Jaycar-Electronics/WiFi-Rover/docs/images/battery.png

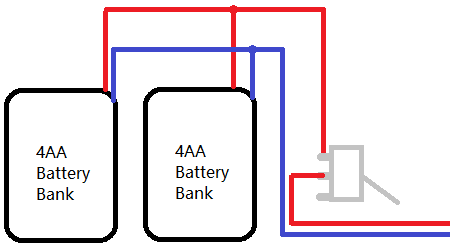
docs/images/battery.png
