Jaycar-Electronics/WiFi-Rover/docs/images/IMAG1243.jpg

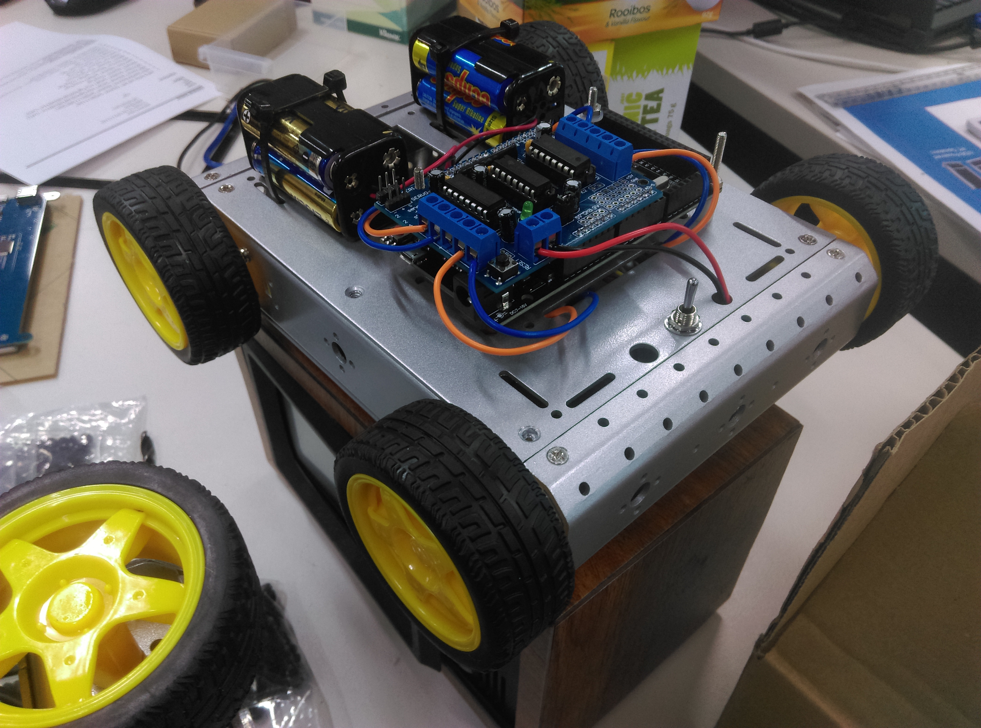
docs/images/IMAG1243.jpg
