Jaycar-Electronics/WiFi-Rover/docs/images/motor.png

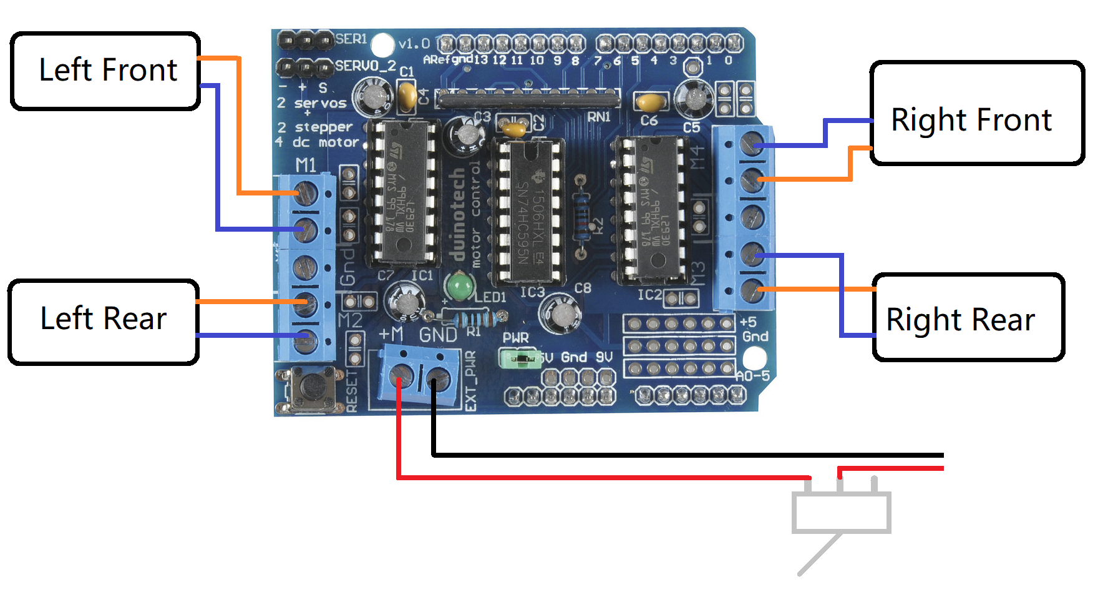
docs/images/motor.png
