Jaycar-Electronics/WiFi-Rover/docs/images/overview2.jpg

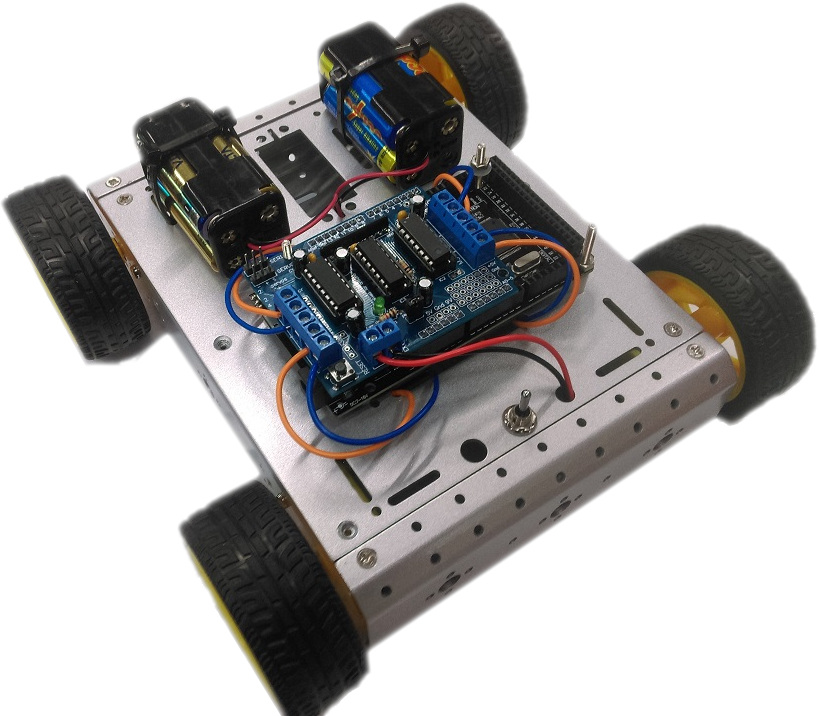
docs/images/overview2.jpg
