Jaycar-Electronics/WiFi-Rover/docs/images/overview.jpg

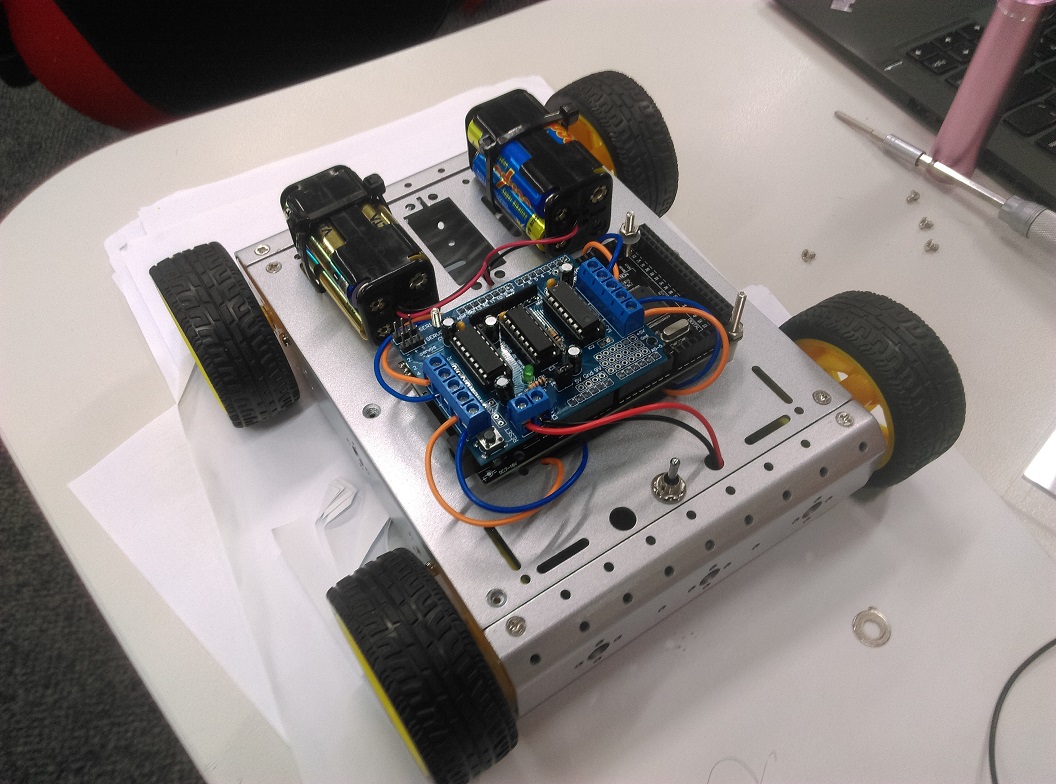
docs/images/overview.jpg
