Jaycar-Electronics/WiFi-Rover/docs/images/roverdata.png

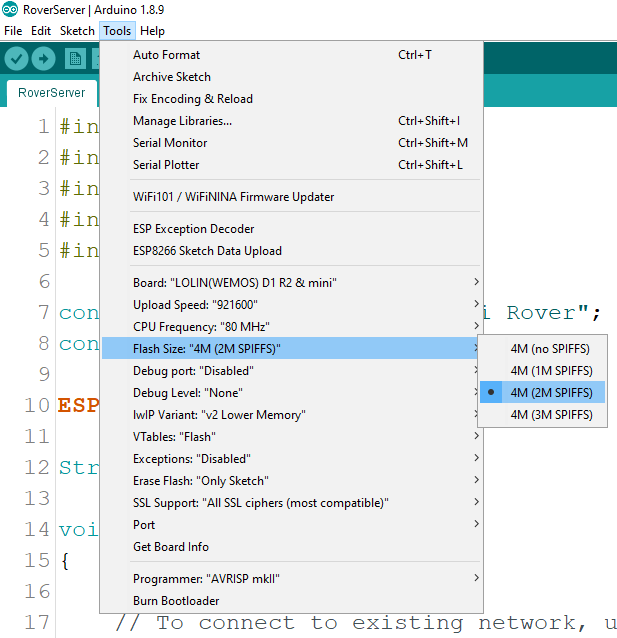
docs/images/roverdata.png
