Jaycar-Electronics/WiFi-Rover/docs/images/RoverSystem.png

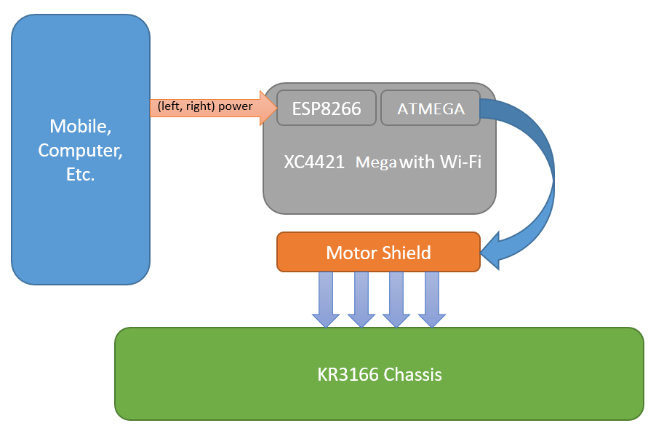
docs/images/RoverSystem.png
