Jaycar-Electronics/WiFi-Rover/docs/images/sbuo.jpg

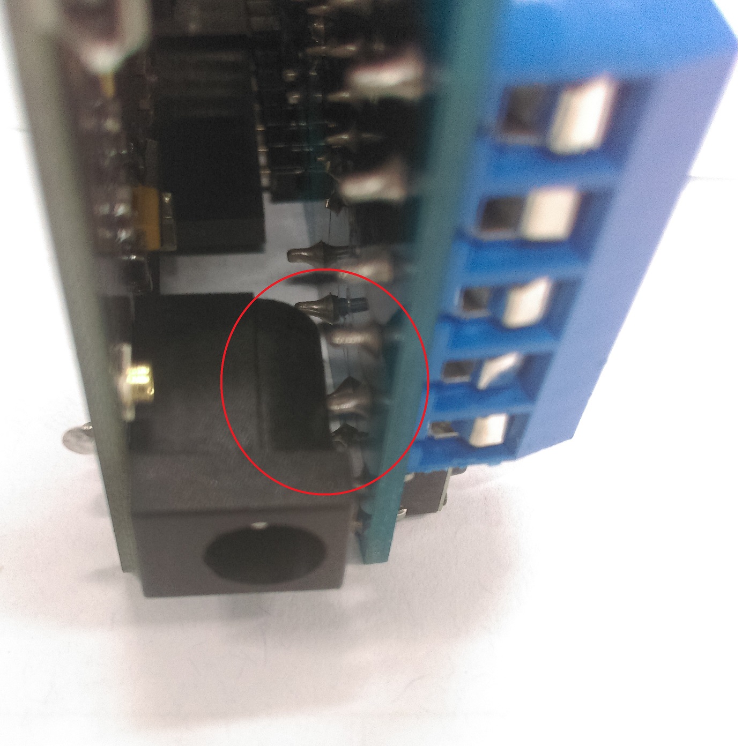
docs/images/sbuo.jpg
