Jaycar-Electronics/WiFi-Rover/docs/images/serial.png

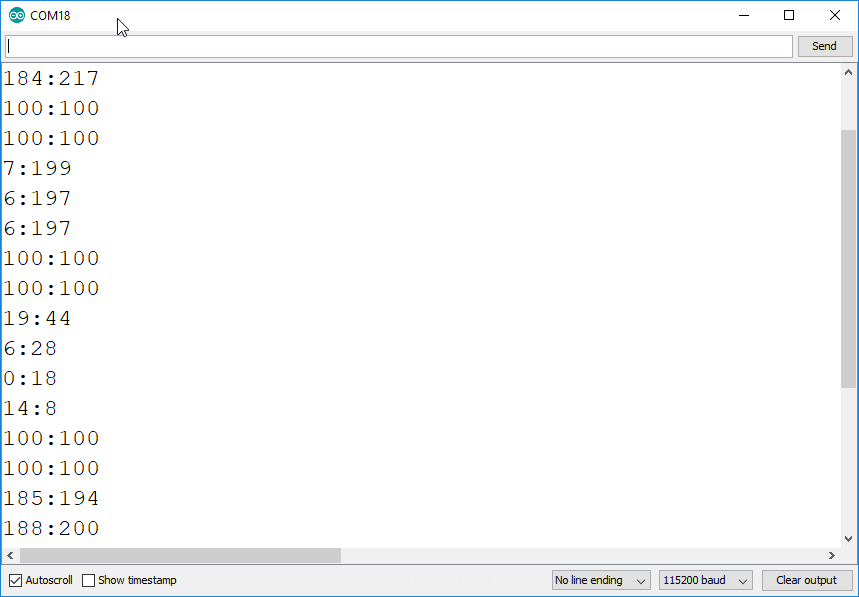
docs/images/serial.png
