Jaycar-Electronics/WiFi-Rover/RoverServer/data/background.png

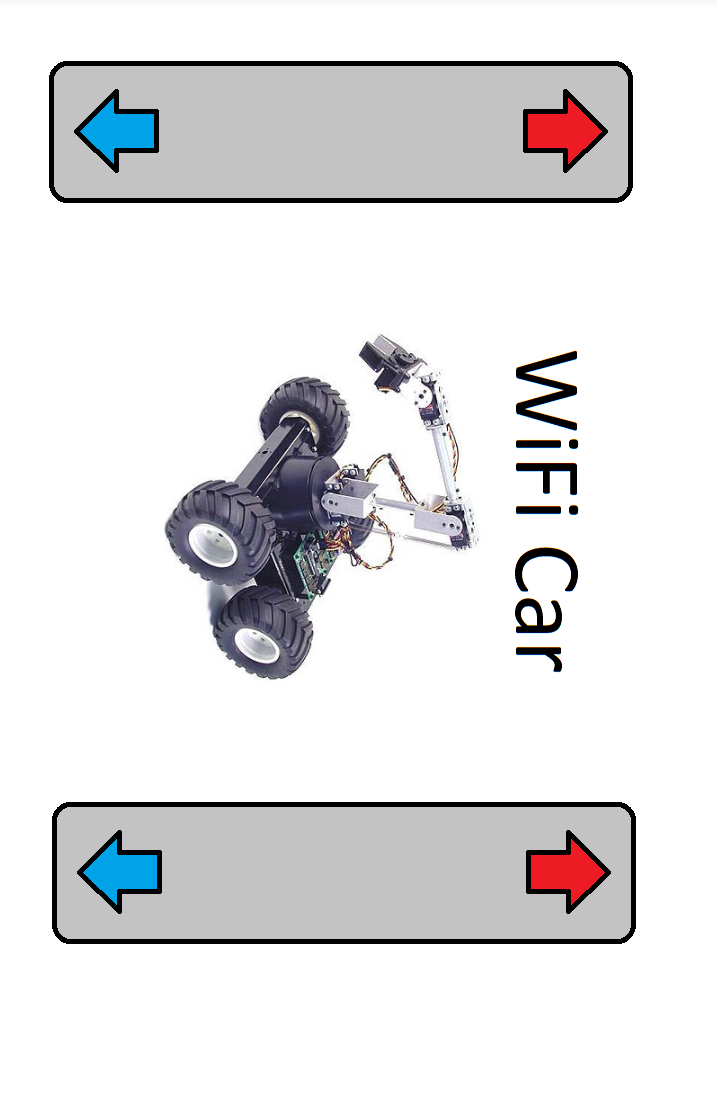
RoverServer/data/background.png
