Jaycar-Electronics/WiFi-Rover/RoverServer/data/background_nonRotate.png

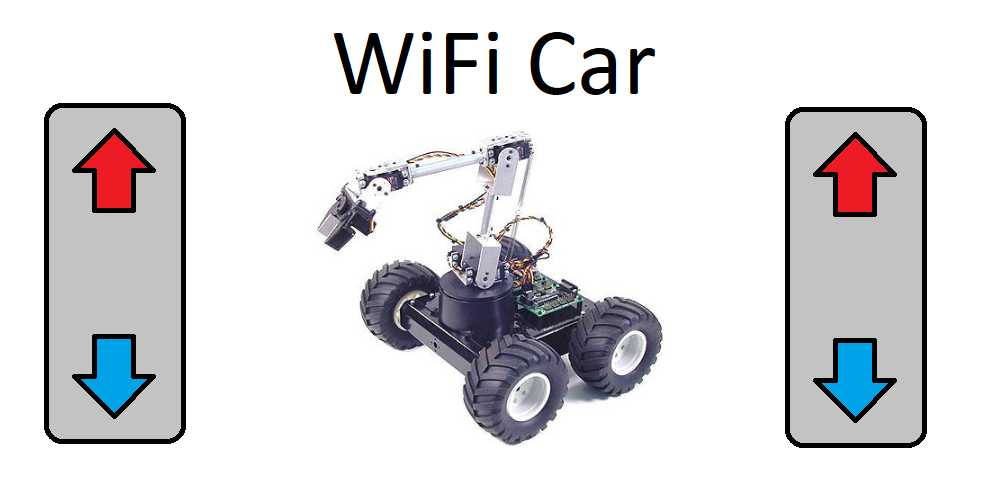
RoverServer/data/background_nonRotate.png
