Jaycar-Electronics/WiFi-Rover/docs/images/step1.jpg

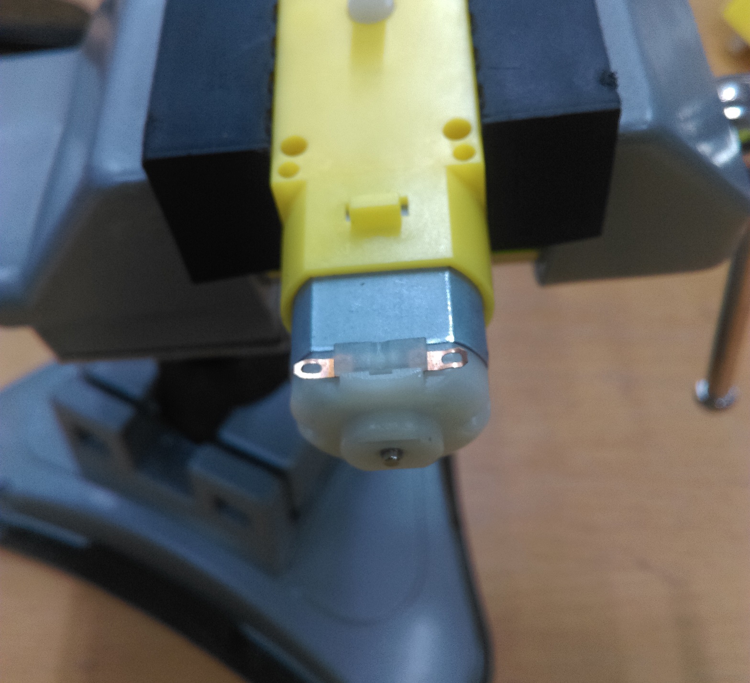
docs/images/step1.jpg
