Jaycar-Electronics/WiFi-Rover/docs/images/step2.jpg

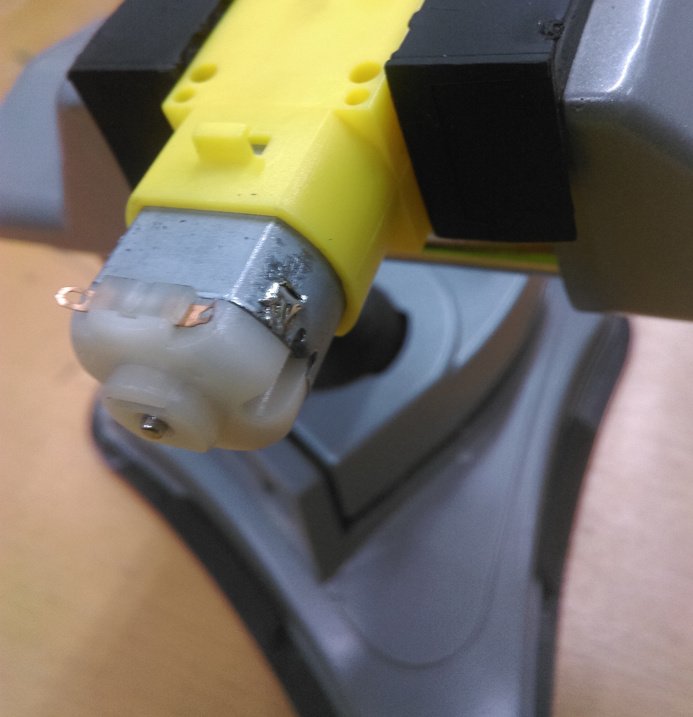
docs/images/step2.jpg
