Jaycar-Electronics/WiFi-Rover/docs/images/step3.jpg

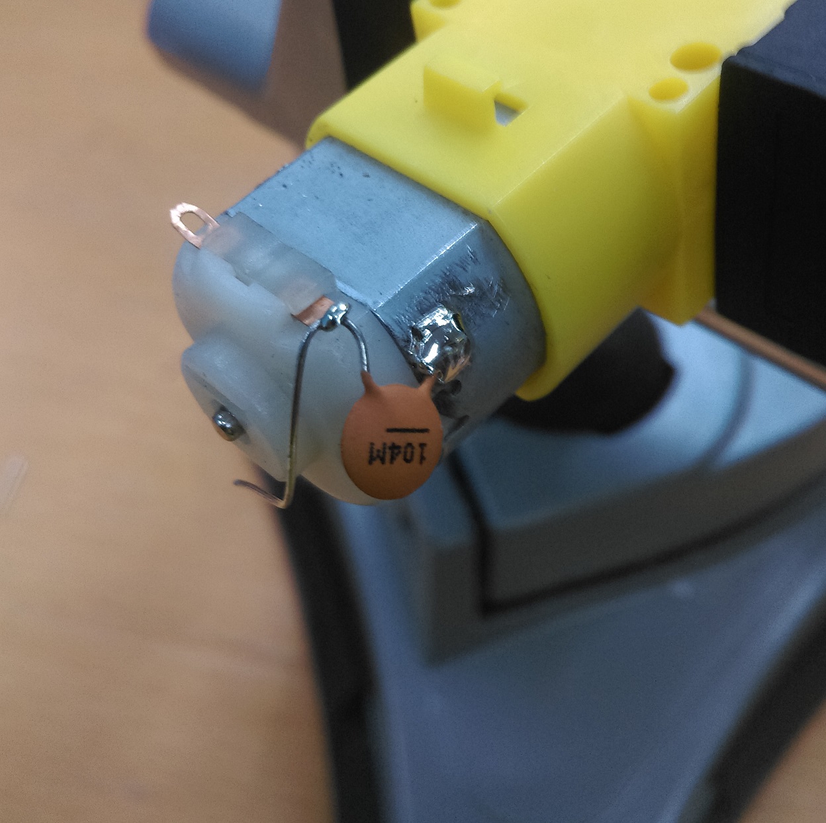
docs/images/step3.jpg
