Jaycar-Electronics/WiFi-Rover/docs/images/step4.jpg

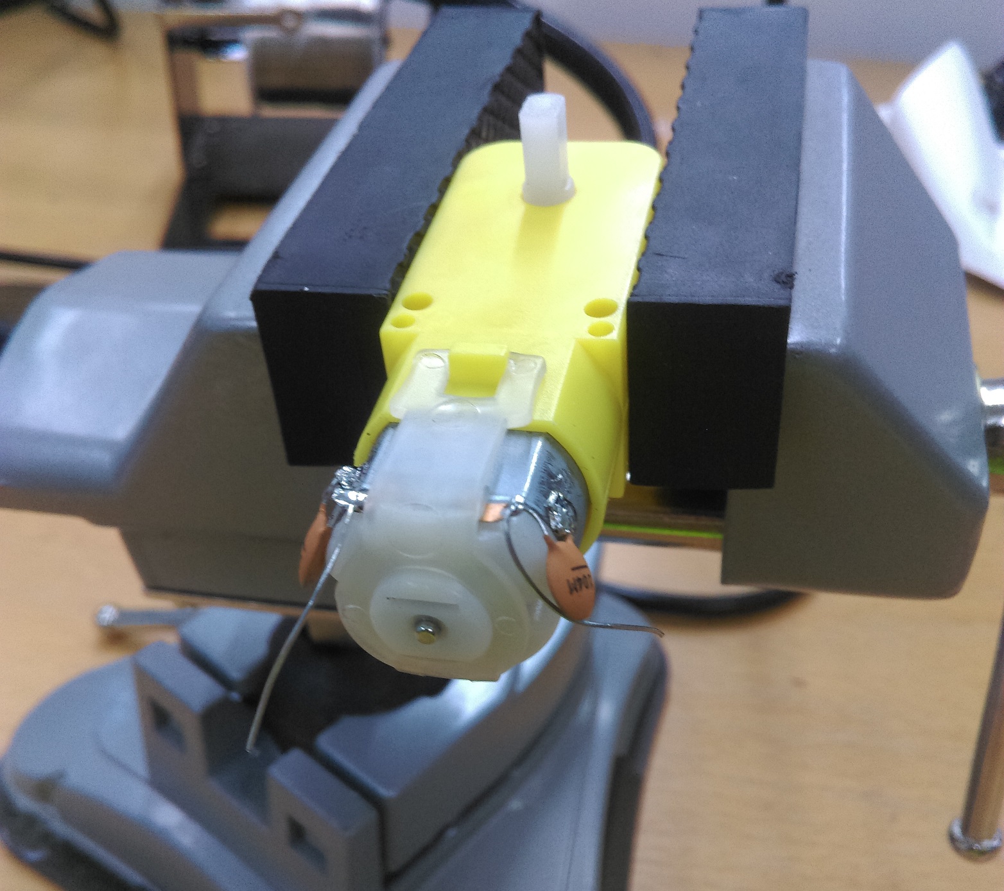
docs/images/step4.jpg
