Jaycar-Electronics/WiFi-Rover/docs/images/step5.jpg

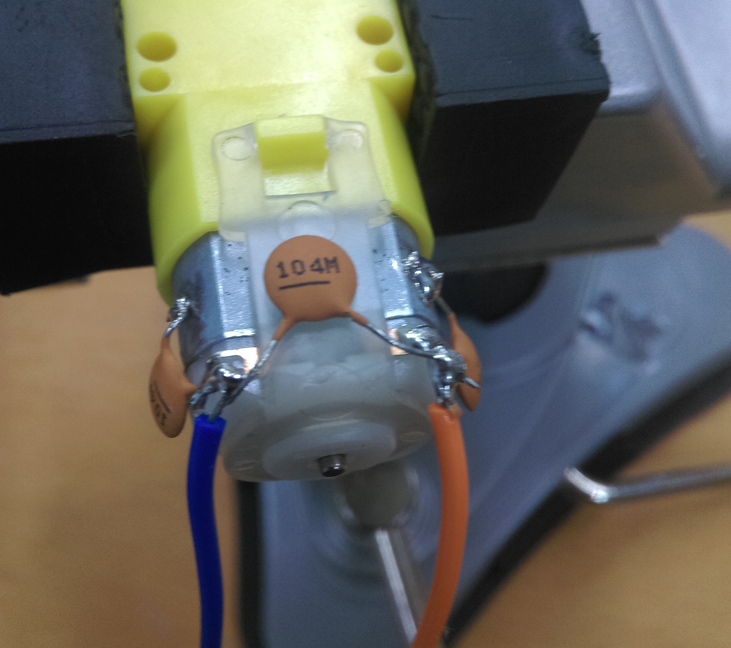
docs/images/step5.jpg
