Jaycar-Electronics/WiFi-Rover/(threads)

Thread 1 (2019-10-08):

SPIFFS Not Supported on avr

iconnor, 2019-10-08:
Getting this error when trying to upload the server part (5,6,7 are on).

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

iconnor, 2019-10-08:
Found that I needed additional boards:

Open Arduino IDE and go to files and click on the preference in the Arduino IDE.

Add the following link to the Additional Manager URLS section: "http://arduino.esp8266.com/stable/package_esp8266com_index.json" and press the OK button.

Then click Tools> Board Manager. Type "ESP8266" in the text box to search and install the ESP8266 software for Arduino IDE.

Jaycar-Electronics, 2020-02-06:
Yep; We'll try and make this more clear-er in the readme: 686ed4c and 1c64893

Good for figuring it out though, hope you've enjoyed it

Closed 2020-02-06.

Thread 2 (2019-12-05):

Wifi Server Keeps dropping off

pilotinavan, 2019-12-05:
Hi,

I can power up the rover, find the webpage and control the rover for short periods, and then the wifi hotspot drops out and I lose connectivity.  Is it possible that the voltage is dropping too low for the esp board, which is turning the signal off?

Cheers

Adrian

Jaycar-Electronics, 2020-02-06:
Sorry about the delay, didn't have email notifications on.

It's possible that there's voltage spikes in the motor circuit; did you solder on the filter caps over the motors? spikes could be crapping out the wifi; Perhaps try connecting up the serial monitor and check some serial message / or watch for a WDT stack error (will spit out a lot of info).

We haven't had similar issues but we might not have ran it for long enough.

The voltage supply shouldn't be that much of an issue but it could be possible; In the future we might investigate changing this to use the [MB3793](https://jaycar.com.au/p/MB3793) power supply, much like the newer "mini tesla" project: [Mini Tesla](https://jaycar.com.au/diy-dodging-robot)

L-m-b, 2020-06-25:
if you bought the kit, take off the PWRJMP jumper and solder a wire from its left pin to the 5v pad on the board.
Only do this if you are using < 7v to power the arduino, as the arduino and wifi module get power through a resistor, then a step down converter, that can make it reset, or not even turn on.

BTW currently trying to figure out if there is a way to tell my android phone not to disconnect because it sees no internet connection.

rObrien74, 2020-09-28:
Hi, Just for some feedback, I was also experiencing the same issue of the wi fi dropping off after each attempt to operate the rover. I had no problem connecting in the first place and the web page displayed as it should. Operation of the controls would result in one drive motion and then the wi fi would drop out. I removed the PWRJMP and hard wired to the 5v pad as L-m-b suggested and the rover now works perfectly. The controls took a little getting used to but one we nailed that it drives well. Now I am planning to try and change the remote to a joystick input with the wifi connection.

Jaycar-Electronics, 2020-09-28:
Very nice. thanks to all of you.

It seems that the battery power just isn't enough juice to operate when the motors are in full spin. Originally we made this to be run off a lithium battery ([MB3793](https://jaycar.com.au/p/MB3793)) which was a bit better at providing power; but it complicated the build a tiny bit and didn't make it to final release; so batteries were used instead in the final minute.

Another possibility is to also / just use a 9V battery, I've only found out recently that the 9V evolta ([SB2916](https://jaycar.com.au/p/SB2916) + [PH9251](https://jaycar.com.au/p/PH9251)) provides more than enough power to move it around on a **regular Arduino**, but I haven't tested it with the UNO+WiFi. (here's a sneak peek image of something we're working on) -- it moves fine just off the 9V battery so I'm starting to feel a bit annoyed that I never tried this sooner.

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

So if anyone else is having similar problems, we could try a few things:

1. try a 9V battery instead, with power jumper ON. no soldering.
2. original battery configuration, solder connection from left jumper pin to 5v.
3. try MB3793

If someone could confirm that 9V works then I'll definitely be able to change up the project page asap, because that seems to be the cheaper and easier option, but I don't have the [XC4411](https://jaycar.com.au/p/XC4411) infront of me at the moment so I can't test.

Jaycar-Electronics, 2020-09-28:
Very nice. thanks to all of you.

It seems that the battery power just isn't enough juice to operate when the motors are in full spin. Originally we made this to be run off a lithium battery ([MB3793](https://jaycar.com.au/p/MB3793)) which was a bit better at providing power; but it complicated the build a tiny bit and didn't make it to final release; so batteries were used instead in the final minute.

Another possibility is to also / just use a 9V battery, I've only found out recently that the 9V evolta ([SB2916](https://jaycar.com.au/p/SB2916) + [PH9251](https://jaycar.com.au/p/PH9251)) provides more than enough power to move it around on a **regular Arduino**, but I haven't tested it with the UNO+WiFi -- it moves fine just off the 9V battery so I'm starting to feel a bit annoyed that I never tried this sooner.

So if anyone else is having similar problems, we could try a few things:

1. try a 9V battery instead, with power jumper ON. **No solder connections**
2. original battery configuration, solder connection from left jumper pin to 5v.
3. try MB3793

If someone could confirm that 9V works (**do not try** it if you have soldered the 5V connection as above) then I'll definitely be able to change up the project page asap, because that seems to be the cheaper and easier option, but I don't have the [XC4411](https://jaycar.com.au/p/XC4411) infront of me at the moment so I can't test.

L-m-b, 2020-10-01:
As a note, I tried 9v before trying to jump it, but it ended up making the motor board drop out (just stopped) the Arduino however worked fine powered by the motor controller from 9v. Results may vary but I do whole heartedly recommend just jumping it, or get a wire to attach to pre existing pins if that can be done easily enough.

L-m-b, 2020-10-01:
Also you should update the guide because it took a lot of figuring out to write to the esp8266 and mega board because some of the guide was pretty ambiguous.

As a note, I basically was directing a class of 20 people to do it in the first place because the guide is fine on terms of physical stuff (disregarding possible power issues) but the software side caught everyone in the class

Thread 3 (2020-06-13):

Can this work with XC4411 Uno with WIFI as per system diagram

JimmyBarrel, 2020-06-13:
I purchased all the hardware, not the Mega (I have the XC4411 as per the system diagram). However I get a compile error against the use of Serial3. Is there any code to have this work on the Uno clone?

L-m-b, 2020-06-18:
having the same issues on the original project board, it also has errors with the af_motor library (i am on linux so it was a pain to get going, but i  managed)
the ESP8266 rover-server project file went onto the board fine, switched the dips over to arduino programming mode again and it won't upload as i originally had issues with, tried switchign the dips around to allow arduino and esp to talk, still no luck with the serial.

might be just an issue with ide compiling it, might be soemthing done wrong on jaycars side.

L-m-b, 2020-06-18:
It's possible the board that they say to use in the documentation is wrong entirely, but i'm gonna try testing it to compile.

L-m-b, 2020-06-19:
HEY, i found that the boards that you add to the arduino ide program don't work at all, but the mega/mega2560 options work, (about 5th from top of default board profile)
try compiling to the uno with that, i have yet to test if it works on my board, could be a few others that work.

JimmyBarrel, 2020-06-19:
I have found the solution to this problem. The Arduino Mega has three physical serial ports and the Arduino Mega has only one. To utilise this with the Uno a software serial is needed for communication with the ESP8266.

The following code compiles (and appears to work)

#include <AFMotor.h>
#include <SoftwareSerial.h>

SoftwareSerial esp8266(0, 1); // RX | TX

AF_DCMotor frontLeft(1);
AF_DCMotor rearLeft(2);
AF_DCMotor rearRight(3);
AF_DCMotor frontRight(4);

char serialBuffer[256] = {0};
short idx; // serial index;

// ---------------------------------------------
// Traditional arduino functions
// ---------------------------------------------
void setup()
{
  // put your setup code here, to run once:

  Serial.begin(115200);  // to the computer ( if connected)
  Serial.println("Startup");
  esp8266.begin(115200); // to the ESP8266
  esp8266.println("OK"); // tell ESP to start up

  frontLeft.run(RELEASE);
  frontRight.run(RELEASE);
  rearRight.run(RELEASE);
  rearLeft.run(RELEASE);
}

void loop()
{
  // put your main code here, to run repeatedly:
  delay(100); // we can delay as the serial events cause the movemment
}

// -------------------------------------------
// This function will be called when there's serial data
// -------------------------------------------
void serialEvent3()
{
  Serial.println("In serial event3");

  while (esp8266.available())
  {

    char data = esp8266.read();

    if (data == '\n')
    { //begin processing data

      serialBuffer[idx] = '\0'; //finalise String

      processSerialData();

      idx = 0; //restart the buffer
    }
    else
    {

      //add it to the buffer and increment the index
      serialBuffer[idx] = data;
      idx++;
    }
  }
}

// ------------------------------------------------------
// Private functions
// -----------------

// it is generally better to make sure that both the left
// and right motors use the same algorithm for speed and power
// so we should put them into their own functions
// that when we change it once, it will change it for both.
int getPower(int reading){
  //atoi can -1; or reading can be 100; for "center"
  if (reading < 0 || reading == 100)
    return 0;
  else
    return 255; // we like max power, you could also use some value of reading.
}

int getDirection(int reading){
  if (reading < 100)
    return BACKWARD;
  else
    return FORWARD; //adafruit constants, isn't nice but ok
}

// -------------------------------------------
// Set Left side motors, either direction
// -------------------------------------------
void setLeft(int reading)
{
  int power = getPower(reading);
  int direction = getDirection(reading);

  frontLeft.setSpeed(power);
  frontLeft.run(direction);

  rearLeft.setSpeed(power);
  rearLeft.run(direction);
}

// -------------------------------------------
// Set Right side motors, depending on position
// -------------------------------------------
void setRight(int reading)
{
  int power = getPower(reading);
  int direction = getDirection(reading);

  frontRight.setSpeed(power);
  frontRight.run(direction);

  rearRight.setSpeed(power);
  rearRight.run(direction);
}

//---------------------------------------------
// extract information from serial and run motors
//---------------------------------------------
void processSerialData()
{
  //send info to computer.
  Serial.println("processing:");
  Serial.println(serialBuffer);

  if (serialBuffer[0] == '%')
  {
    return; //we can receive comments and do nothing with them.
  }

  //this gets a "pointer" to where ':' is in the string
  char *sep = strchr(serialBuffer, ':');

  //if we have a pointer:
  if (sep != 0)
  {

    *sep = 0; //change ':' into NULL; terminating the string.

    // now, serialBuffer as a string will only be up until the
    // original ':' character, as we've nulled the string at this
    // point.
    short leftMotor = atoi(serialBuffer);

    // thankfully, we still have that pointer; we can
    // increment it THEN send to atoi ( precrement );
    // which will get the next segment of data:
    // the pointer up until the original NULL char; (see 10 lines up)
    // for the next segment, until the original NULL char.

    short rightMotor = atoi(++sep);

    Serial.print("setting left to ");
    Serial.println(leftMotor, DEC);

    Serial.print("setting right to ");
    Serial.println(rightMotor, DEC);

    setLeft(leftMotor);
    setRight(rightMotor);
  }
  else
  {
    //send information to the computer, because we have a bug
    Serial.println("Sep is:");
    Serial.println((int)sep, HEX);
    Serial.println((int)*sep, HEX);
    Serial.println(*sep);
  }
}

JimmyBarrel, 2020-07-07:
After much trial and error I have determined that even though you can get this to work on the Uno wifi it isn't a great solution. The Arduino has 1 hard serial and then my code above used an additional soft serial - but both hit the same pins on the ESP8266. This impacts the ability to communicate with a PC serial and the the Arduino-ESP communications. The Mega wifi on the other hard allows switching between serial ports between the Arduino and the ESP - thus enabling two ways communications between the two AND communication with your PC. All in all a better experience with the Mega over the Uno.

Jaycar-Electronics, 2020-07-21:
Sorry for the late response guys.

Yes, Mega is preferred due to the extra serial ports.

You can theoretically get it to work if you change `Serial3` -> `Serial` but you won't get any debug information on the Arduino IDE; The serial port will only connect between the UNO and the ESP. much like how Jimmy Barrel pointed out.

Also thanks for pointing out the error in the system diagram. I've fixed this here: https://github.com/Jaycar-Electronics/WiFi-Rover/commit/7b66e364124e52176e0ce3d0eaa13de55a392f53

I'll close the ticket as the solution does exist but it's not ideal. People interested in such can read the information above. ( @JimmyBarrel I've edited your comment because you mentioned "Mega" when you were meant to say "Uno" and also included syntax. )

Closed 2020-07-21.

Thread 4 (2020-12-06):

Missing file from code and pin to use if not using Motor sheild

42Drivertrainer60, 2020-12-06:
when trying to Verify and Compile the sketch I get a Message " AF Motor.h No such file or directory"
Also what pins to use if your not using a Motor Shield !! but a Arduino Compatible Stepper Motor Controller Module
CAT.NO: XC4492.
I feel that the code is incomplete.

Regards Gino
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

ShmapplePie, 2021-04-16:
Better late thsn never so here goes...
First, ensure you have the *Adafruit Motorshield V1 Library* installed in your arduino IDE. If you haven't, Install them by going to the Manage Libraries section.
You need to ensure there is no space and the case is exact when writing the code
 `#include <AFMotor.h>`

This code was written and includes libraries for the **L293D** motor shield. I don't know if they are compatible with yours, so any compatibility problems you may have to see if there is a different library you need to reference and different functions to write. The shield you show above is a **L298N** dual motor driver.

42Drivertrainer60, 2021-04-17:
Thanks for getting back to me, months latter, but its better then never.
when I try to verify and compile the RoverServer code I get an error message "ESP8266WiFi.h no such file or directory "
and when I try to compile and verify RoverUno code I get an error message "Serial 3 was not declared in this scope"
I have installed the Adafruit AFmotor v1 library since i don't have a motor shield what pins do I connect the motor driver ENa, in1,in2, ENb in3,in4 regards gino

ShmapplePie, 2021-04-17:
Sorry, I'm a hobbyist just like you building this project now so I wasn't able to help months ago. But maybe now that I'm here I can try and help work out your issues. I'm no professional, so I can't promise miracles, but I'm happy to help if I can.

If you go to the webpage for the wifi module ESP8266 there are instructions on how to download the files from their github page and extract them to the right place. You need to do this to be able to install them in the Arduino IDE, its a seperate controller from the motor shield, so the Adafruit Library isnt the one it needs.

As for the other issues, maybe try installing the 8266 wifi libraries first and see if that made any difference and go from there?

42Drivertrainer60, 2021-04-17:
Hi
Thanks for the reply.
I too are a hobbieist I used to write code 30 years ago but now its so
different hard to see the flow of the code, it's like playing chess you
look at the game from start to finish.
I've been at this for months, there's heaps of free code but there written
for specific Arduinos, tried to modify them but no success, because most
have two seperate codes one for Arduino Uno,or nodemcu and the other for
ESP 8266 module or just the ESP8266 module only ,the WiFi Rover is
promising but I can't work out were to connect the motor driver pins to the
duiontech dual board, with the motor shield, it just plugs into the top of
it.
I would have to modify the code but I need to work out were to connect the
motor driver pins to the duiontech.
I would appreciate any help you can provide.
I have built my robot but without this part working it's useless.

Regards Gino

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

ShmapplePie, 2021-04-17:
The duinotech mega with wifi (the board I'm using) essentially is two boards in one - I have to switch over some dip pins to be able to upload the arduino sketch and then flip those switches and plug it in again to upload the wifi code onto the wifi side. Then after that switch it back so the two "sides" can talk to each other.

Probably best to just treat it like two boards plus a motor shield on top.

As for your pins and code issues, its a matter of looking and seeing which pin from the shield is in which number output, and in any code carefully change the numbers they use to the ones you have. Like for instance if I needed to connect an LED to pin 12 on a mega but I only had a UNO with pin 3 free, I would change the code from saying
`pinMode(12, OUTPUT)`
Change that to
`pinMode(3, OUTPUT)`
And any other instance referring to pin 12 has to be 3 too. It really can be as simple as that if you're careful to trace exactly which pins on your board are connected on the shield and the original author was nice enough to leave their code commented and tidy.

Option B is to just buy a mega with wifi, they are a little on the pricey side, but for a beginners project I would probably suggest either following the parts list to the letter, learning C++ Arduino to be able to adapt your board to this project, or finding another 4WD project made with a UNO you can copy.

Checkout Hackaday.io for heaps of electronics projects made by folks like us. I've seen 4WD arduino cruisers over there, and they sometimes share their code on GitHub too. Best of luck!😄

ShmapplePie, 2021-04-17:
Just a thought, you may also be able to take your project into a Jaycar store and just ask the people that work there. A lot of the employees and customers are pretty hardcore hobbyists and even some like myself are electronics engineers.

They may be able to help you tweak this code or even just wire your board on the same pins as the mega to save the drama, show you how to install the 8266.h library you need (which is why it says it cant find it when you go to upload), maybe if you go in at a time they aren't busy or walk in and make an appointment you can get some hands on tips?

Just a thought 🤷‍♀️

42Drivertrainer60, 2021-04-18:
Hi Codie
Thanks for the information, I know how the mega works it's not what I want,
when I went to Jaycar I asked for the same hardware as in the instructions,
but they gave me duinotech dual board and motor driver not the motor shield
and I questioned it but they said it's just as simple, that was six months
ago. It didn't come with instructions so I had to Goto there website and
get the user manual.
In the Jaycar instructions I can't see which pins are used and can't work
it out from the code, I have contacted Jaycar to get this information, and
they said somebody would get back to me, that was 8 months ago.
I have looked at numerous codes but all for one board and not dual boards,
I have written a code one for ESP side and the other for Arduino side, they
both complied fine, the ESP side works, after uploading and resetting the
board I can see and connect to the ESP but when I turn it off and then on
again the ESP would drop out, and when I try to upload to the Arduino It
can't find it, it seems that it's looking for the ESP! I don't know how to
change the code From ESP to Arduino .I have looked at numerous forums but
no help found.
Does the header have anything to do with the board?
Eg. #include <Arduino.h> = Arduino board?
       #include <ESP8266.h> = ESP8266 board?
Regards Gino

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

ShmapplePie, 2021-04-20:
Ok, I have time today so let's see what we can work out together! And always best to start from the top since I don't know what steps have been taken or if they were done properly, so bear with me while you catch me up to speed, but if its a code issue I can help. Only just starting to fiddle with arduino code but I do know C++ so I have a head start there.

Post me a list of the product or model numbers for both the duinotech board you're using and the motor shield/driver board. We will make sure first that your IDE is recognising your mainboard, the appropriate libraries are installed and referenced.

Link me to any code you are using or better yet begin a new GitHub repository so I can have a look at the code you are using specifically in context - that will help so much. Also upload photos of the boards wired up with any pin numbers clearly shown so we can work out what goes where.

Its a lot of work but if you start a repo and add me to it I'm happy to work with you in any spare time I have. I'm also building this project with the Mega+wifi board, but using it as a base for a robot as a side project for my uni electronics club. Better to learn together though, I'm sure we can work it out.

ShmapplePie, 2021-04-20:
Also I keep forgetting to mention, have you been into a Jaycar at a quiet time and asked the staff about your issue? Chances are someone there will be an arduino geek like us and be able to shed some light on your issue, though the code side is hard without it in front of them.

But if it its a hardware issue they may be able to help, just make sure its a quiet time in store so they have a minute to help, maybe even call and see if you can make an appointment? Not sure how to go about it, I've never worked there but worth a shot?

42Drivertrainer60, 2021-04-20:
Hi Codie
First thanks for your time and help! I appreciate it.
I have uploaded phots of my set up in GitHub but can't find how to upload
the sketch.
The 2 boards on the right are power converters

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

42Drivertrainer60, 2021-04-20:
#include <SoftwareSerial.h>/// This is the sketch for the ESP side

/* Pins 8, 9, 10 and 11 of Arduino are connected to L298N Motor Driver
Input pins i.e.
IN1, IN2, In3 and IN4 respectively*/

#define IN1 8
#define IN2 9
#define IN3 10
#define IN4 11
#define DEBUG true
#define ENB 5
#define ENA 6

IPAddress ip(192, 168, 4, 2);
IPAddress netmask(255, 255, 255, 0);
const int port = 80;//Port
ESP8266WebServer server(80);

SoftwareSerial esp8266Serial(ENB, ENA); //Pin 2 & 3 of Arduino as RX and
TX. Connect TX and RX of ESP8266 respectively.
String command;
int speedCar = 80;
int speed_Coeff = 3;

const char *ssid = "WiFi Car";
const char *password = "";
const char * subnet = "255, 255, 255, 0 ";

void setup()
  {
    pinMode (ENB, OUTPUT);
    pinMode(ENA, OUTPUT);
    pinMode(IN1, OUTPUT);
    pinMode(IN2, OUTPUT);
    pinMode(IN3, OUTPUT);
    pinMode(IN4, OUTPUT);
    digitalWrite(ENB, LOW);
    digitalWrite(ENA, LOW);
    digitalWrite(IN1, LOW);
    digitalWrite(IN2, LOW);
    digitalWrite(IN3, LOW);
    digitalWrite(IN4, LOW);
    Serial.begin(9600);

    esp8266Serial.begin(115200); //Baud rate for communicating with
ESP8266. Your's might be different.
    esp8266Data("AT+RST\r\n", 5000, DEBUG); // Reset the ESP8266
    esp8266Data("AT+CWMODE=1\r\n", 5000, DEBUG); //Set station mode
Operation

    /*Change the following command as per your requirement i.e. enter the
    SSID and Password of your WiFi Network in the command.*/

    esp8266Data("AT+CWJAP=\"Ginos optus\",\"42mightysandy60\"\r\n", 5000,
DEBUG);//Enter your WiFi network's SSID and Password.

    /*while(!esp8266Serial.find("OK"))
    {
      }*/

    esp8266Data("AT+CIFSR\r\n", 5000, DEBUG);//You will get the IP Address
of the ESP8266 from this command.

    /* The following statement is to assign Static IP Address to ESP8266.
    The syntax is AT+CIPSTA=<ip>,<gateway>,<netmask>.
    This will assign a Static IP Address of 192.168.1.254 (in my case)
    to the ESP8266 Module. Change this value as per your requirements i.e.
this IP address
    shouldn't conflict with any other device.
    Also, the second and third parameters are Gateway and Net Mask values.
    You can get these values from ipconfig command in command prompt*/

esp8266Data("AT+CIPSTA=\"192.168.4.2\",\"192.168.0.1\",\"255.255.255.0\"\r\n",
3000, DEBUG); // Assign Static IP Address
    esp8266Data("AT+CIFSR\r\n", 5000, DEBUG);//You will get the IP Address
of the ESP8266 from this command.

    esp8266Data("AT+CIPMUX=1\r\n", 5000, DEBUG);
    esp8266Data("AT+CIPSERVER=1,80\r\n", 5000, DEBUG);
  }

void loop()
  {
    if (esp8266Serial.available())
      {
        if (esp8266Serial.find("+IPD,"))
          {
            String msg;
            esp8266Serial.find("?");
            msg = esp8266Serial.readStringUntil(' ');
            String command1 = msg.substring(0, 5);
            String command2 = msg.substring(6);

           if (DEBUG)
              {
                Serial.println(command1);//Must print "robot"
                Serial.println(command2);//Must print "FWD" or "REV" or
"LFT" or "RGT" or "STP"
              }
            delay(100);

              if (command2 == "FWD")
                {
                  forward();
                 }
                 if (command2 == "REV")
                {
                  reverse();
                 }
                 if (command2 == "RGT")
                {
                  right();
                 }
                 if (command2 == "LFT")
                {
                  left();
                 }
                 if (command2 == "STP")
                {
                  stoprobot();
                 }

          }
      }
  }

void forward()
{
  digitalWrite(IN1, HIGH);
  digitalWrite(IN2, LOW);
  digitalWrite(IN3, HIGH);
  digitalWrite(IN4, LOW);
}

void reverse()
{
  digitalWrite(IN1, LOW);
  digitalWrite(IN2, HIGH);
  digitalWrite(IN3, LOW);
  digitalWrite(IN4, HIGH);
}

void left()
{
  digitalWrite(IN1, LOW);
  digitalWrite(IN2, LOW);
  digitalWrite(IN3, HIGH);
  digitalWrite(IN4, LOW);
}

void right()
{
  digitalWrite(IN1, HIGH);
  digitalWrite(IN2, LOW);
  digitalWrite(IN3, LOW);
  digitalWrite(IN4, LOW);
}

void stoprobot()
{
  digitalWrite(IN1, LOW);
  digitalWrite(IN2, LOW);
  digitalWrite(IN3, LOW);
  digitalWrite(IN4, LOW);
}

String esp8266Data(String command, const int timeout, boolean debug)
  {
    String response = "";
    esp8266Serial.print(command);
    long int time = millis();
    while ( (time + timeout) > millis())
      {
        while (esp8266Serial.available())
          {
            char c = esp8266Serial.read();
            response += c;
          }
      }
    if (debug)
      {
        Serial.print(response);
      }
    return response;
  }

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

Dotrar, 2021-04-20:
Sorry, I'm not working here anymore.

Changing to the XC4492 instead of the XC4472 should be a fairly easy change over, as long as you know how the motor shields work (and the code that works with them).

These instructions are really only specified for XC4421 (MEGA+WIFI) and the XC4472 (MOTOR SHIELD) -- once you start changing parts, the code won't "just work" like it did previously and you have to change multiple things. I know that the UNO+WIFI won't work simply as it only has 1 serial connection to the wifi, and then changing the motor controller as well requires a different library... and you're basically changing too many things at once and getting confused.

I would suggest that you build it bit-by-bit. ie:

* do you have simple example code that spins the wheels. - if not, make it, then save it and put it aside
* do you have simple example code that reads wifi data - if not, make it, then save it and put it aside
* do you have simple example code that communcates by serial  - if not, make it, then save it and put it aside.

that's probably going to be the only real way you can build up from scratch. If you can't even get the XC4421 working, I suggest you check out the manual for the product here: https://www.jaycar.com.au/medias/sys_master/images/images/9487296069662/XC4421-manualMain.pdf

as well as the ESP+ARDUINO setup instructions here:
https://www.jaycar.com.au/medias/sys_master/images/images/9486646607902/XC3802-manualMain.pdf

ShmapplePie, 2021-04-21:
Ok... not sure where this code came from but its got both the code for the wheels and the WiFi controls in it, and as far as I'm aware those are *two* separate chips and need to be uploaded accordingly, treat them like two separate boards. Also you need to know if you must set any Dip switches before uploading, otherwise you won't be able to get any code on them.

*ESP* chip gets the *WiFi* stuff, wheels get the movement, and between them only code that says something like if WiFi says move then motor moves, which will be a copy on Arduino's chip and a copy on the WiFi chip, with the Dip switches set so they can talk to each other.
And that's apart from the syntax errors, though I could be mistaken on that one, but I do see an IP address with commas?

I think you would be better off scrapping this code, reading the docs for your Arduino module (whether that's the UNO or the Mega), going back to the beginning and ensuring your libraries are installed, you understand how the shields talk to each other, and how to upload to them.

I would break it down like this:

1. Identify the hardware you have and read the manuals so you know where to find the drivers and libraries for them and have them installed correctly. For starters, the ESP8266 library is [found here](https://github.com/esp8266/Arduino) along with instructions on how to install it in the Arduino IDE.
Oh and find out if your wifi module has a storage space for the webapp files, otherwise that part wont work and will have to be hosted elsewhere, which is a whole new complication.

2. Make sure you know how to upload to the Arduino and WiFi separately (using dip switches or another method it specifies in its manual) then set them back together (if not already a separate Arduino and WiFi module in addition to your stepper motor shield)

3. Play with the motors a little, as Dotrar said, make one wheel move on a timer or have a switch wired up to test. You could even try a simulator such as [TinkerCAD circuits](https://www.tinkercad.com/learn/circuits) to get a feel for Arduino code and how it interacts with the hardware, it's a great Arduino simulator and totally free to use, with very helpful tutorials.

4. Then _**read the original code that is posted in this repo**_ and try and follow it piece by piece, the `#include` headers may or may not be different but the rest of the code should be fairly similar. It won't work from a simple copy paste but hopefully you went back and learned your hardware and learned some new tricks with Arduino coding that it should be easy to adapt.

That's basically it, I can't write the code for you since I'm still not sure which Arduino and Wifi module you're using, plus I'm also working on my own robot too, but hopefully this has given you some new ideas and you'll be able to go back and troubleshoot step by step and make it work. Good Luck!

42Drivertrainer60, 2021-04-21:
Hi Codie
Thanks heaps for your help and advice taking the time to help me out I know
how busy you must be with your own things.
Looking at hundreds of tutorials I have discovered that
1. L298n motor driver if using EN pins they must be connected to the PWM
pins of the Arduino this is if your running more than twelve volts through
the motor driver
2 if your connection is to PWM pins than this has to be initiated in the
code. PWM controls the speed.

3. You have to install the L298N library into Arduino otherwise it may not
work download it from GitHub repository

Hopefully this is as useful to as it is to me
Regards Gino

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

42Drivertrainer60, 2021-04-21:
Hi
forgot to mention that the email I sent you with the code is actually 2
codes one for the Arduino side and the other for the ESP side. I couldn't
work out how to upload it to GitHub didn't want to send 2 separate emails
is what I should have done.

Regards Gino

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
